RoboticaGrupo11/curly-eureka/mi_bot_11/resources/Background3.png

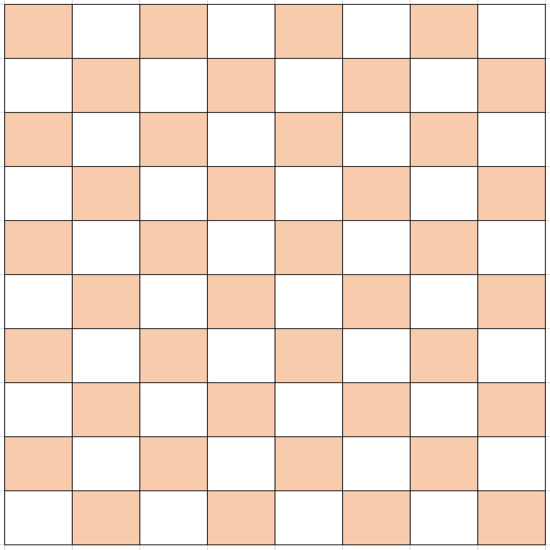
mi_bot_11/resources/Background3.png
