RoboticaGrupo11/curly-eureka/Planos/Planos mecánicos/Plano ensamble ISO (mm).pdf

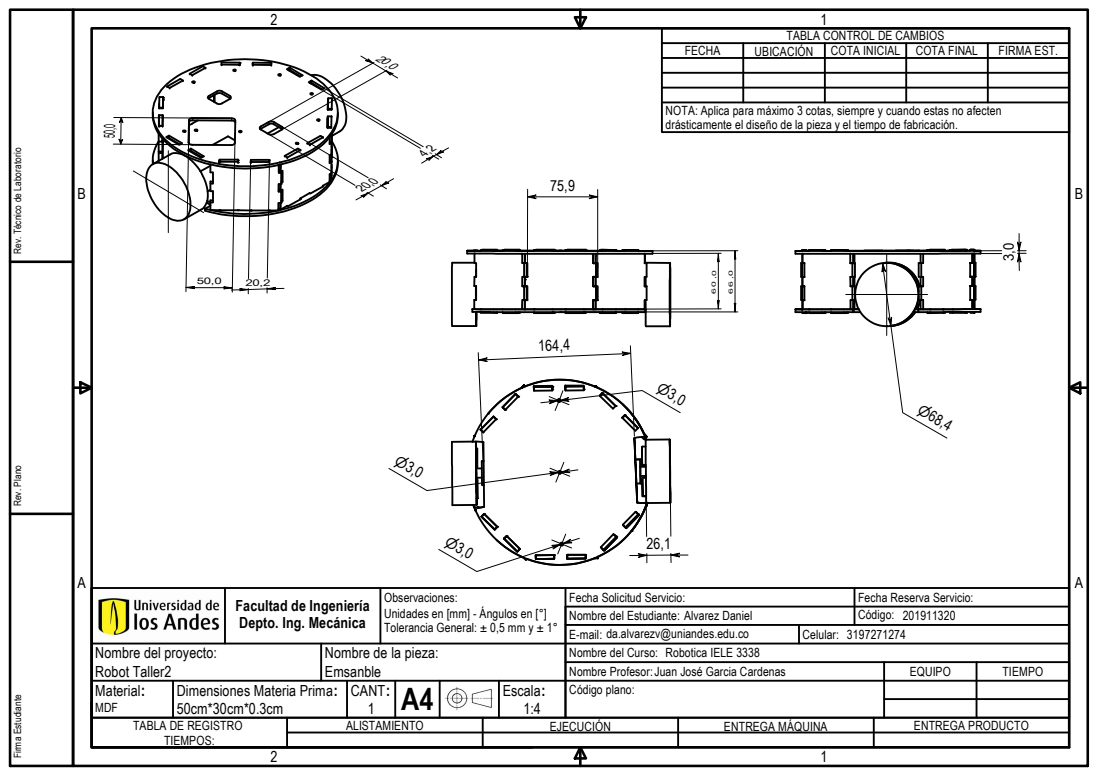
[picture p12: page 1]
FECHA; UBICACIÏN; COTA INICIAL; COTA FINAL; FIRMA EST.

TABLA CONTROL DE CAMBIOS

NOTA: Aplica para miximo 3 cotas, siempre y cuando estas no afecten
dristicamente el disexo de la pieza y el tiempo de fabricaciyn.

Rev. Plano Rev. Tpcnico de Laboratorio Firma Estudiante

Facultad de Ingenierta Depto. Ing. Mecinica | Observaciones: Unidades en [mm] - Èngulos en [°] Tolerancia General: ± 0,5 mm y ± 1° | Fecha Solicitud Servicio: | Fecha Reserva Servicio:

Nombre del Estudiante: Alvarez Daniel | Cydigo: 201911320
da.alvarezv@uniandes.edu.co E-mail: | 3197271274 Celular:

Nombre del proyecto: Robot Taller2 | Nombre de la pieza: Emsanble | Nombre del Curso: Robotica IELE 3338

Nombre Profesor: Juan Josp Garcia Cardenas | EQUIPO | TIEMPO

Material: | Dimensiones Materia Prima: | CANT: 1 | A4 | | Escala: | Cydigo plano:
MDF | 50cm*30cm*0.3cm | | | | 1:4

TABLA DE REGISTRO TIEMPOS: | ALISTAMIENTO | | EJECUCIÏN | ENTREGA MÈQUINA | ENTREGA PRODUCTO
