RoboticaGrupo11/curly-eureka/Planos/Planos eléctronicos/Schematic.pdf

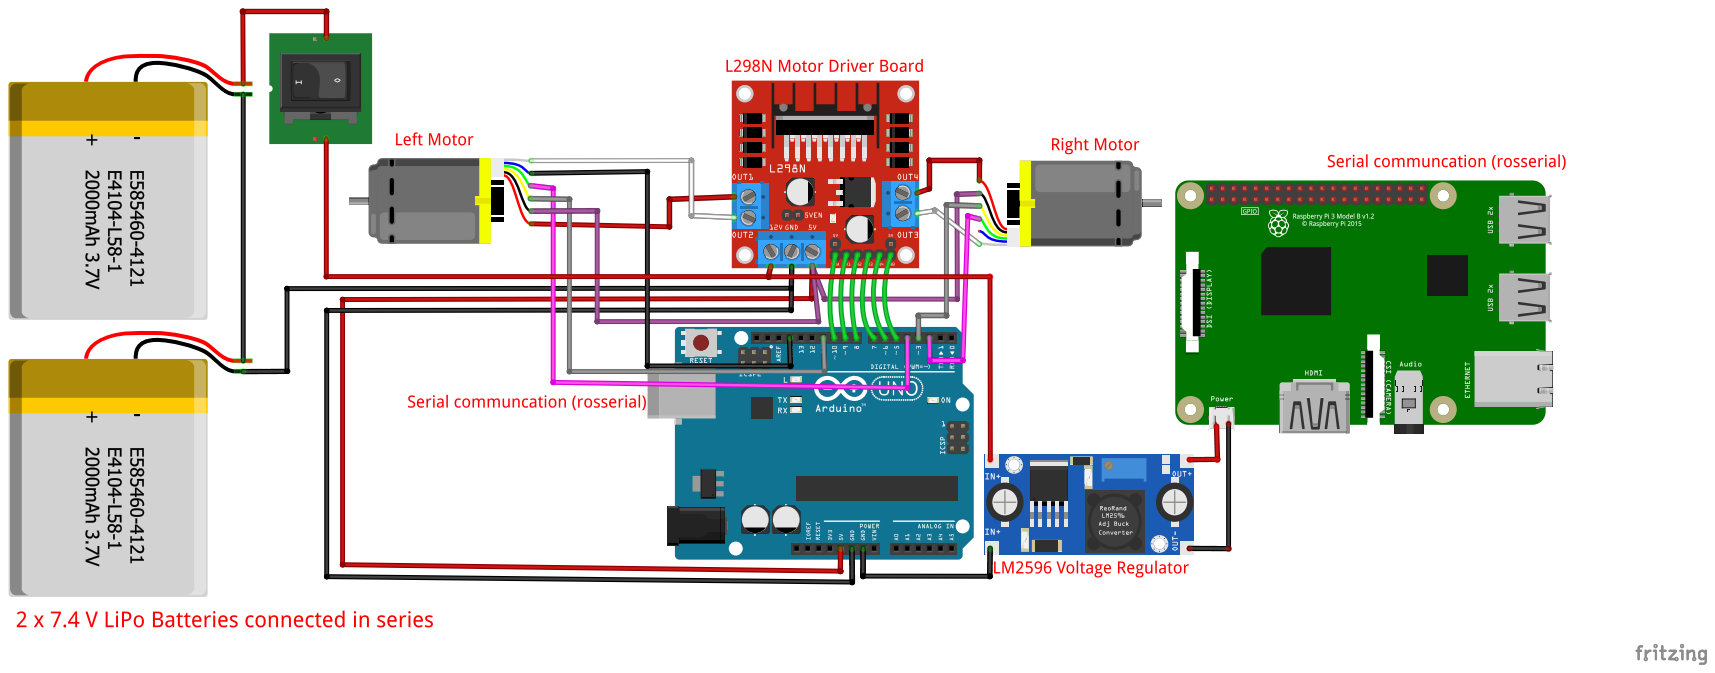
[picture p13: page 1]
