RoboticaGrupo11/curly-eureka/(commit log)

2022-03-28 Arduino, mirobot11
2022-03-28 Create punto2.py with initial odometry suscriber
2022-05-07 UPDATE MOTORCONPID
    JAJAJA MERA PERRA
